xlisp/mpcc-3d/mpcc_3d_log.md

我刚查完莴苣的两个帖子,并用他公布的数据核算了一下光路,下面是结果。

**帖子里能确认的内容**
- 他的设计就是给 F/5 牛反(例如信达小黑)用的,和你的望远镜一致。
- 镜片来自淘宝"鼎盛光电仪器厂",镜片成本约 50 元,和你买的两片价格吻合。具体焦距和直径写在网盘资料里,我打不开,所以"镜片完全相同"只能说合理,无法逐项核对。
- 两片镜片的**中心距离 7.754mm,边缘距离 5.337mm**,隔圈(帖子里的 P3)厚 5.337mm。
- **后截距 50.5mm**,从平凸镜的凸面顶点量到相机感光面。他说这个值是固定的,对焦靠调整调焦座,不是靠改间距。
- 他用的是尼康 F 口卡口,可另购 M42 转 M48 转接环拧在镜筒上接滤镜;零件 P1、P2、P3 用黑色 PLA 打印。
- 他自己说理论上比信达一代 MPCC 稍差,会增加一点边缘渐晕,但能有效改善 F/5 抛物面镜的边缘彗差。

另外你前面贴的资料里的"55mm 后截距",来自 2023 年那个帖子里的**名扬成品 MPCC**(莴苣是设计师)。他自己的 DIY 镜片版是 50.5mm,这两个数不能混用。我 README 里写的"成品 55mm"没有区分,需要改。

**我的设计和他的主要差别**

| | 莴苣 | 我做的 |
|---|---|---|
| 两镜间距 | 中心 7.754 / 边缘 5.337mm | 隔圈 10–26mm,是我猜的 |
| 后截距 | 固定 50.5mm | 没有设计,靠延长筒凑 |
| 镜片顺序 | 凸面顶点最靠近传感器 | 平凸镜放在进光口一侧 |
| 接口 | 相机卡口,另购 M42 转 M48 | 2" 插入筒进、M48 出 |

我的间距和顺序都有问题。我用他的间距和后截距做了一次近轴核算(忽略镜片厚度,只是粗略验证):
- **负透镜在前、平凸镜在后**:焦距缩放系数约 0.99,也就是约 1 倍,和他说的"1X MPCC"一致。
- **平凸镜在前**(我现在的布局):约 0.90 倍。

我之前在 README 里写的"像个 0.8 倍减焦镜",就是因为间距猜大了、顺序也可能反了,结论不可靠。

我推断他的顺序是负透镜靠近副镜,平凸镜在传感器一侧,平面朝向负透镜,是因为:
- 他用平凸镜凸面顶点量后截距。
- 他给的边缘距离小于中心距离,说明负透镜的凹面朝向平凸镜的平面。

这个推断没看到装配图验证。

**建议的改法**
1. 把镜片顺序和间距改成他的数据,间距约 5.3mm(边缘)/7.75mm(中心),不再做 10–26mm 隔圈。
2. 把后截距 50.5mm 作为设计目标,镜筒出口到感光面的距离按相机法兰距和延长筒配好。
3. 修正 README 里关于顺序、间距和 55mm 的说法。

要我按他的数据重做吗?重做前需要你告诉我两样东西:你的相机型号(法兰距)、你实测的两片镜片边缘厚度。

------------
已按莴苣的数据重做了设计,`mpcc.py` 和 `README.md` 都更新到 v2。我重新生成了 STL,全部通过封闭性检查。

**改了什么**
- **光路顺序**:负透镜(27mm)在前,平凸镜(41.5mm)在后,平面朝负透镜、凸面朝相机。这个朝向是我根据他的数据推断的,没有看到装配图。
- **间距**:两镜边缘间距 5.337mm,隔圈按这个做,另外多打了 ±0.5mm 两个备选(`spacer_gap4.84/5.34/5.84.stl`)。
- **后截距**:以平凸镜凸面顶点到感光面 50.5mm 为目标。
- **结构**:插入筒缩短到 25mm,主体总长 38.8mm,凸面顶点基本与出光端面持平。
- **README**:改正了两镜间距、镜片顺序和后截距的说法,并区分了你贴的资料里的 55mm 和他 DIY 版的 50.5mm。

**需要你补两个数据**
- **相机型号**:脚本打印出,从 M48 台阶面到感光面应为 58.6mm。其中 17.5mm 是帖子里 ASI533 的法兰距,我只当示例用,脚本里 `CAM_FLANGE` 要改成你的相机,延长筒长度才算得准。
- **镜片边缘厚度**:`LA_T=4.0`、`LB_T=3.0` 还是我的估计值,请用卡尺量一下。

**一个要核对的疑点**
他的帖子里中心与边缘间距差 2.42mm,而你的 -185mm 负透镜如果是平凹,凹面在 r=13.5mm 处矢高只有约 1mm。所以他的镜片和你的可能不完全一致,或者他的测量位置不是我理解的那样。他的镜片规格在网盘资料里,我打不开。你如果能打开网盘,把镜片参数或图纸发我,我可以直接核对。

先打 `coupon` 试螺纹松紧,再打主体和隔圈。

-------

我读了他的三个 STL(P1、P2、P3),没有改我的设计。图片和 SLDPRT 我这边打不开,下面的结论是从 STL 几何里读出来的,标了"推断"的地方是我的判断。

**能直接确认的**
- **P3 就是隔圈**:外径 41.3mm,内径 25.5mm,厚 5.337mm,是个平环。它一面顶着负透镜的边缘,另一面顶着平凸镜,所以 5.337mm 就是两镜边缘间距。我的隔圈思路与此一致。
- **P2 是 2" 镜筒**:外径 50.8mm,总长约 16.8mm。其中一段是外径 50.8 的插入段,约 11.8mm。另一端有外螺纹,外径约 45.5–46.6mm。
- **负透镜座**:孔径 27.3mm、深 3.0mm,前面有一圈通光孔径 26.4mm 的挡边。这说明他的负透镜边缘厚度约 3.0mm,和我估计的 `LB_T=3.0` 一致。
- **平凸镜座**:孔径约 41.8mm,深 8.78mm,里面放 P3 隔圈和平凸镜。推断平凸镜边缘厚度约 3.4mm,比我默认的 4.0mm 小。
- **P1 是相机侧的压盖**:通光孔径 35.4mm,压住平凸镜。

**顺序上也对得上**
从 P2 的结构看,负透镜在进光口一侧,平凸镜在相机一侧,这和我 v2 的顺序一致。

**我之前的疑点可能有解释**
中心与边缘间距差 2.42mm,比平凹 -185mm 负透镜在 r=13.5mm 处约 1mm 的矢高大。如果这片负透镜其实是**负弯月形**,朝向平凸镜的凹面曲率半径约 38mm,这个差距就能解释。这是推断,没法验证。

**和我设计的主要差异**
- 他的插入段只有约 11.8mm,我做了 25mm。
- 他的 P1 是旋在镜筒上的压盖,我用的是 M44 内螺纹压圈。
- 他的负透镜通光孔径 26.4mm,我的约 25.8mm。

**需要你再帮一下**
你把 `装配图.png` 和 `点列图.png` 直接发到对话里,我就能看到图。装配图可以确认两片镜片的朝向和各零件的相对位置,点列图可以看他的设计在各视场的表现。看完后我再按他的结构调整,比如平凸镜边缘厚度改成约 3.4mm、负透镜通光孔径改成 26.4mm,并决定要不要改成他那种压盖结构。

----
