xlisp/mpcc-3d/stl/MPCC_APSC_P1_ZWO125.STL

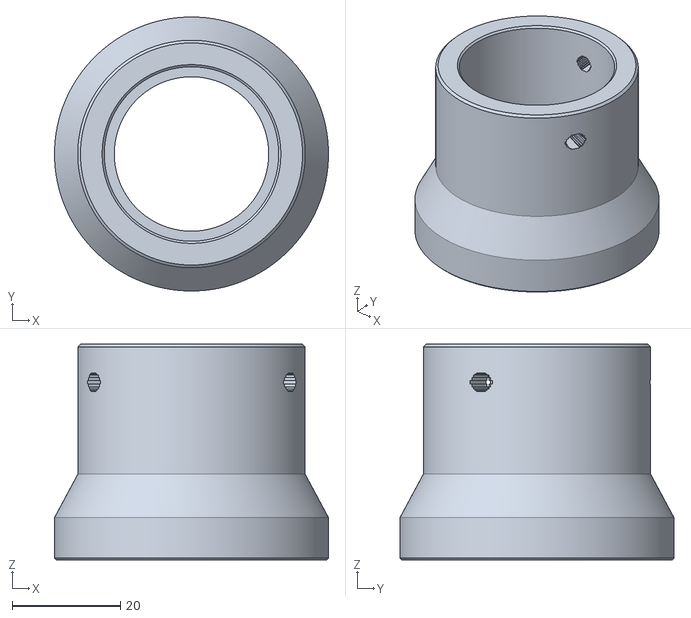
[picture p1: CAD file, 2026-11-14]
stl/MPCC_APSC_P1_ZWO125.STL
50.6 x 50.6 x 39.8
