xlisp/mpcc-3d/stl/spacer_gap5.34.stl

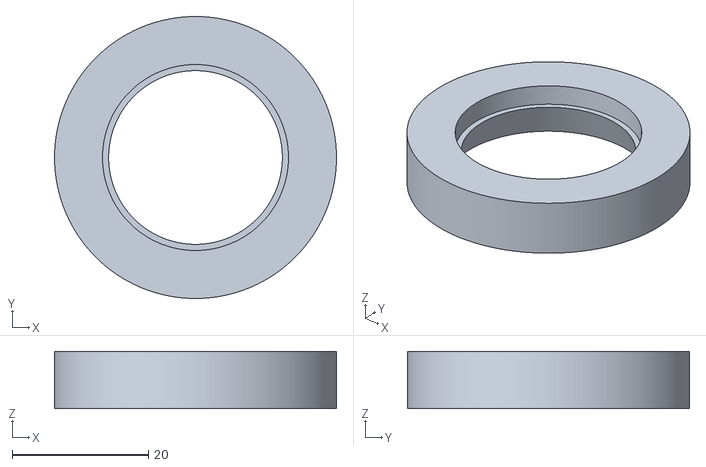
[picture p2: CAD file, 2026-11-08]
stl/spacer_gap5.34.stl
41.4 x 41.4 x 8.44
