xlisp/mpcc-3d/stl/ring.stl

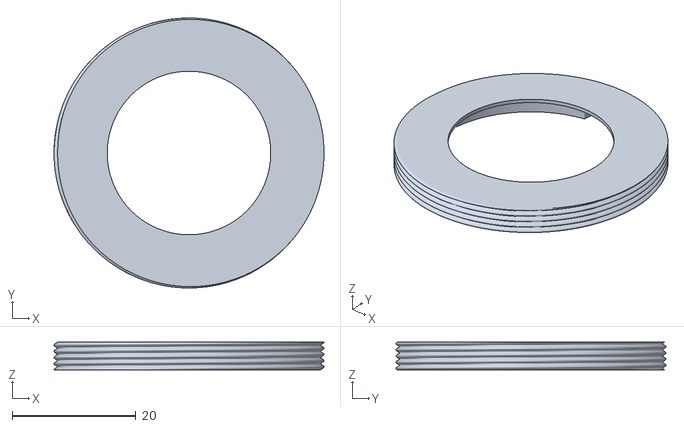
[picture p3: CAD file, 2026-11-08]
stl/ring.stl
43.6 x 43.6 x 4.50
