xlisp/mpcc-3d/stl/spacer_gap4.84.stl

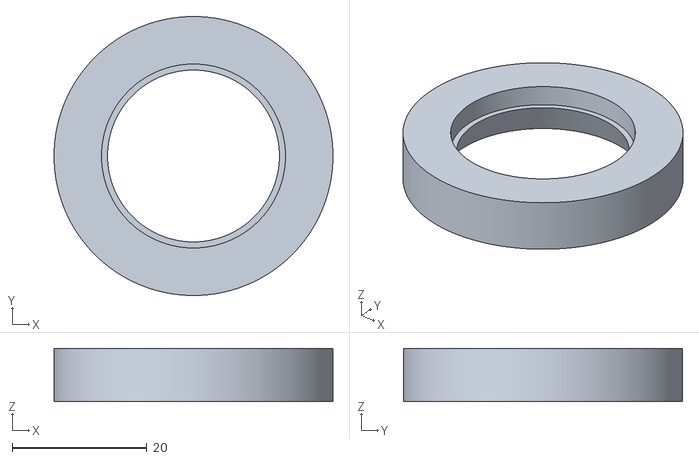
[picture p4: CAD file, 2026-11-08]
stl/spacer_gap4.84.stl
41.4 x 41.4 x 7.94
