xlisp/mpcc-3d/stl/body.stl

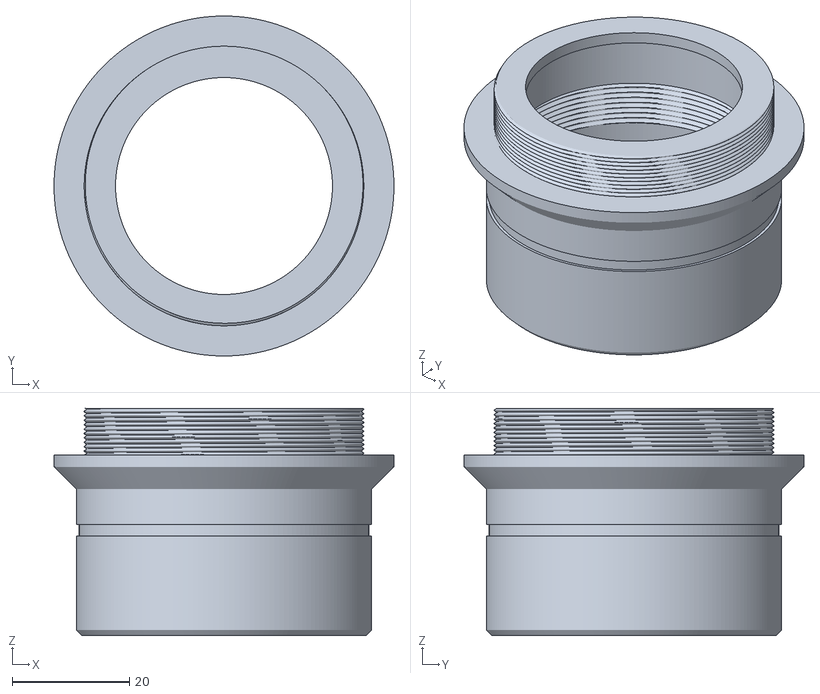
[picture p6: CAD file, 2026-11-08]
stl/body.stl
58.0 x 58.0 x 38.8
