xlisp/mpcc-3d/stl/coupon_m44_int.stl

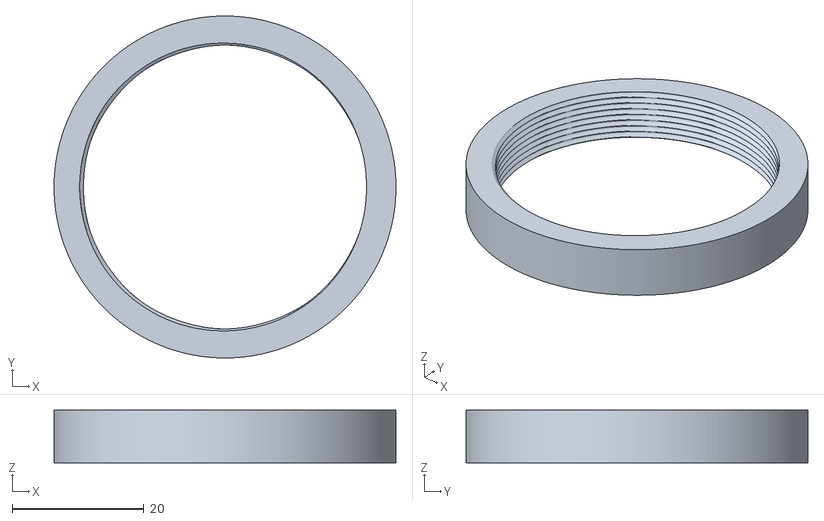
[picture p7: CAD file, 2026-11-08]
stl/coupon_m44_int.stl
52.0 x 52.0 x 8.00
