xlisp/mpcc-3d/stl/coupon_m48_ext.stl

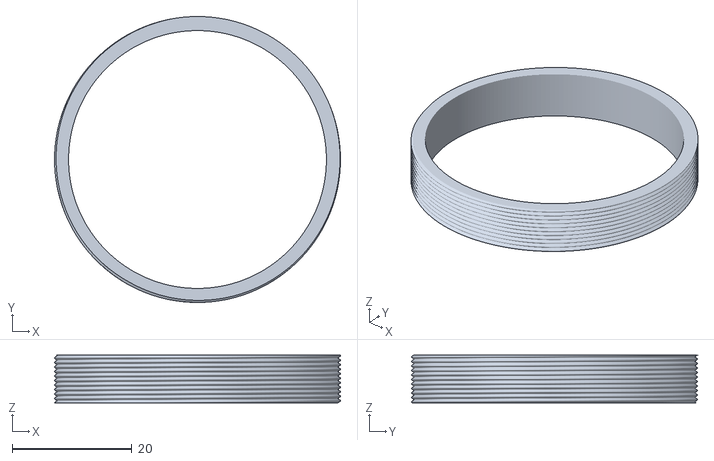
[picture p8: CAD file, 2026-11-08]
stl/coupon_m48_ext.stl
47.7 x 47.7 x 8.00
