xlisp/mpcc-3d/(commit log)

2026-11-08 调用mcp， /Users/xlisp/PyPro/mcpp_3d python 画一些 stl 3D件，做一个MCPP 3D打印件。我手头有两个镜片，信息如图片所示。MPCC 彗差改正镜 的 3 D可以参考另外一个图，不过我这里需要的是2寸入和两寸接口出，信达老黑10寸牛反F5上使用的。
    [body.stl, coupon_m44_int.stl, coupon_m48_ext.stl, ring.stl, spacer_10.stl, spacer_14.stl, spacer_18.stl, spacer_22.stl]
2026-11-08 已按莴苣的数据重做了设计,mpcc.py 和 README.md 都更新到 v2。我重新生成了 STL,全部通过封闭性检查。
    [body.stl, ring.stl, spacer_10.stl, spacer_14.stl, spacer_18.stl, spacer_22.stl, spacer_26.stl, spacer_gap4.84.stl]
2026-11-08 WIP 参考莴苣的设计，修改
    [body.stl, ring.stl, spacer_gap4.84.stl, spacer_gap5.34.stl, spacer_gap5.84.stl]
2026-11-14 调用mcp ， /Users/xlisp/Documents/APS-C_MPCC资料 目录帮我做个替代 MPCC_APSC_P1.STL 的打印件，用python生成，因为我不是用尼康单反，我是用zwo 533mc相机，所以需要能接1.25寸口 。
    [MPCC_APSC_P1_ZWO125.STL]
